juulsA/usb-c-pd-vps/hardware/ps-ch/step-models/WE-HCI_1890.stp

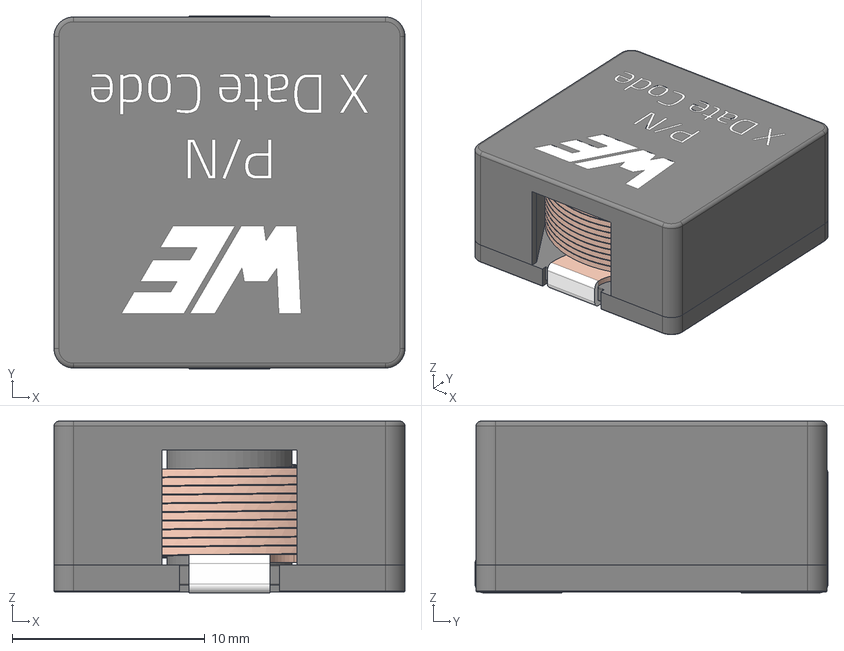
[picture p2: CAD file, 2025-10-03]
hardware/ps-ch/step-models/WE-HCI_1890.stp
18.2 x 18.3 x 8.90 mm
Gehäuse
Boden
Spule
