juulsA/usb-c-pd-vps/hardware/ps-ch/step-models/atx203sa.step

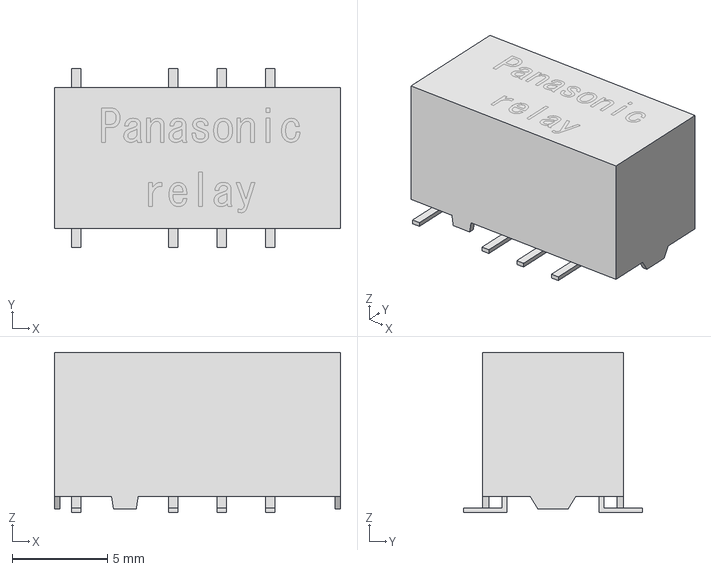
[picture p3: CAD file, 2025-10-03]
hardware/ps-ch/step-models/atx203sa.step
15.0 x 9.40 x 8.40 mm
