juulsA/usb-c-pd-vps/hardware/ps-ch/step-models/RPH0016B.stp

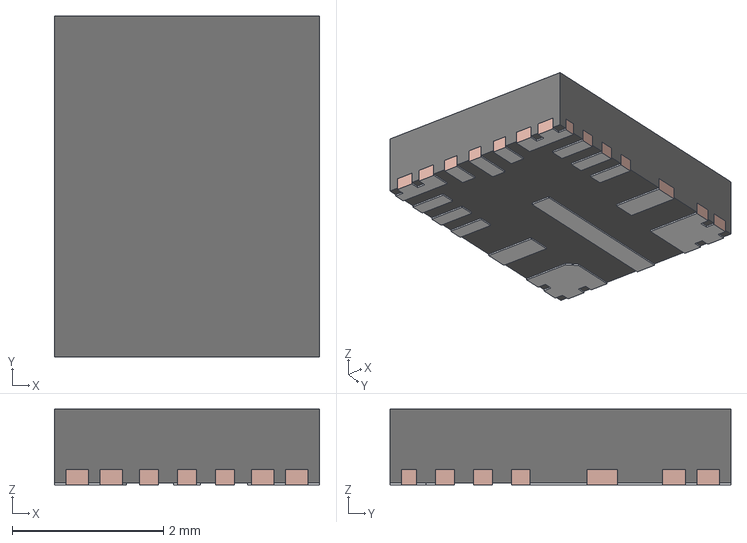
[picture p4: CAD file, 2025-10-03]
hardware/ps-ch/step-models/RPH0016B.stp
3.50 x 4.50 x 1.00 mm
FRAME
