juulsA/usb-c-pd-vps/hardware/ps-ch/step-models/WE-LQS_6045.stp

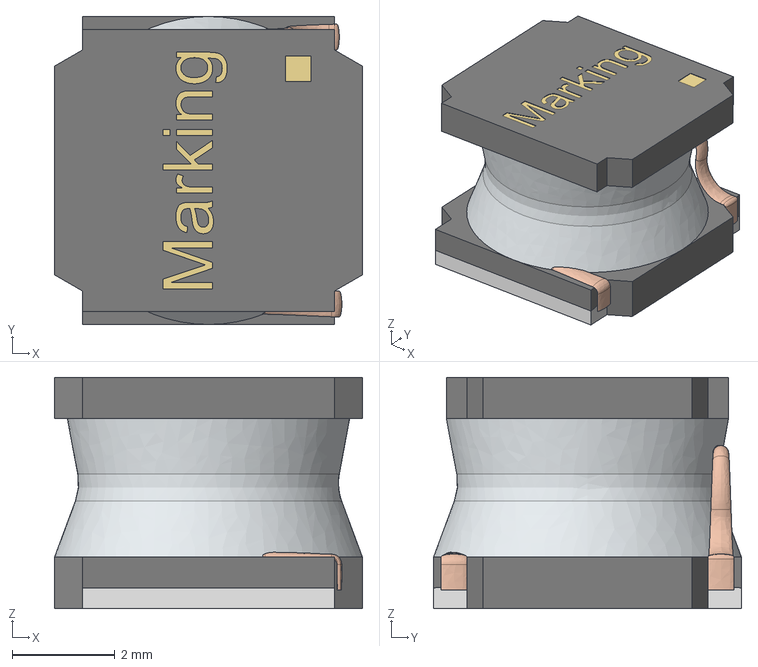
[picture p5: CAD file, 2025-10-03]
hardware/ps-ch/step-models/WE-LQS_6045.stp
6.00 x 6.00 x 4.50 mm
