juulsA/usb-c-pd-vps/hardware/ps-ch/step-models/WE-HCI_5040.stp

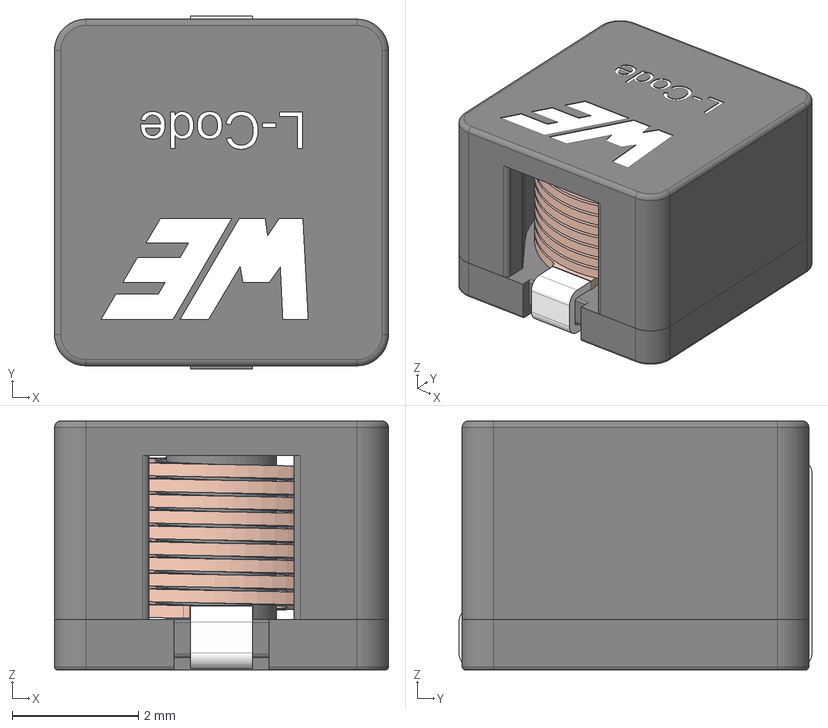
[picture p6: CAD file, 2025-10-03]
hardware/ps-ch/step-models/WE-HCI_5040.stp
5.30 x 5.60 x 3.95 mm
Gehäuse
Boden
Spule
