juulsA/usb-c-pd-vps/hardware/ps-ch/step-models/SOT669.step

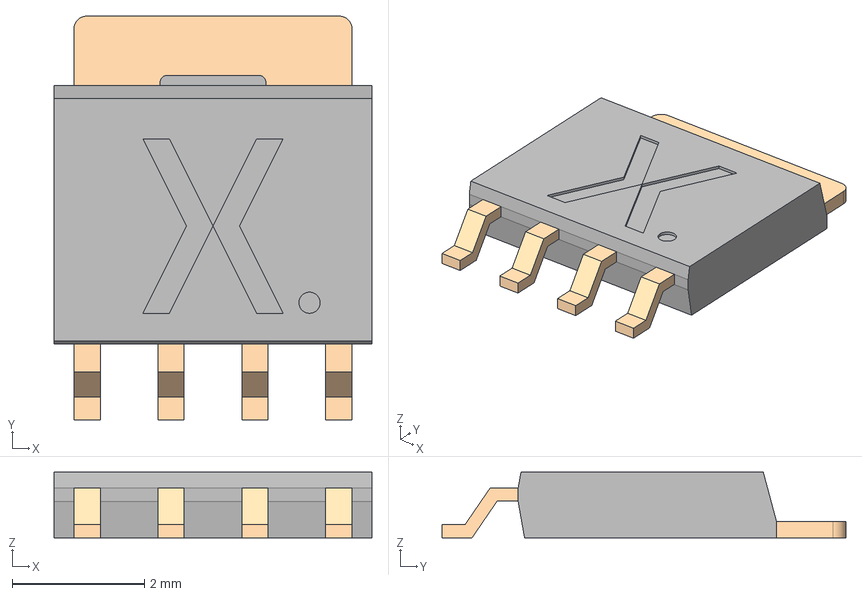
[picture p7: CAD file, 2025-10-03]
hardware/ps-ch/step-models/SOT669.step
4.81 x 6.11 x 0.998 mm
