juulsA/usb-c-pd-vps/hardware/ps-ch/step-models/EFD25.STEP

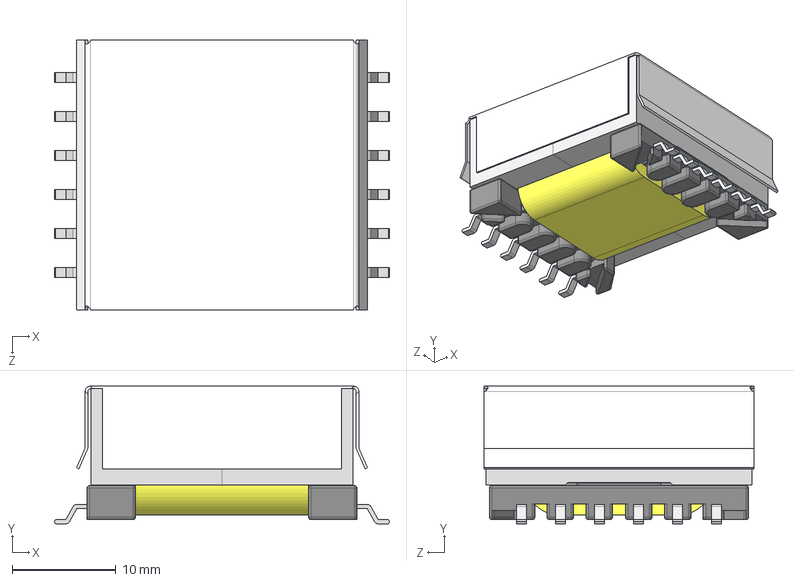
[picture p8: CAD file, 2025-10-03]
hardware/ps-ch/step-models/EFD25.STEP
32.3 x 13.3 x 26.0 mm
070-4476_6H
070-4476_coil
150-2104_6B x 2
139-0178_6B
