juulsA/usb-c-pd-vps/hardware/ps-ch/step-models/0009652028.stp

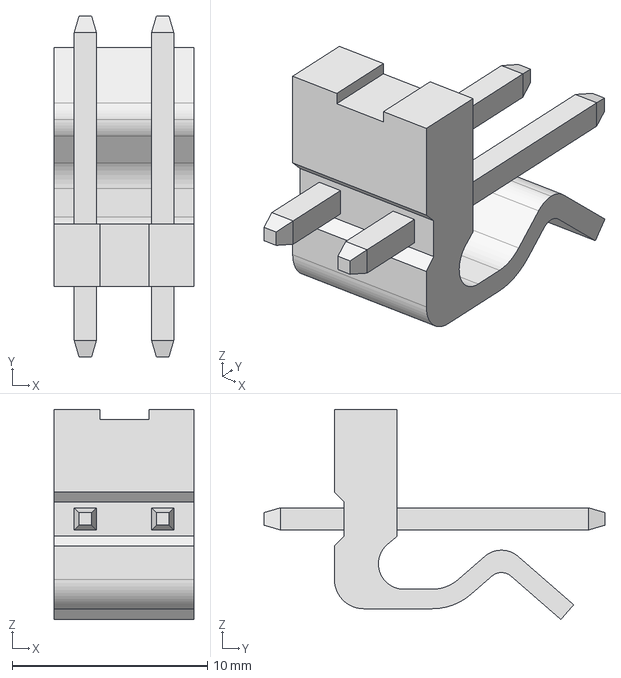
[picture p9: CAD file, 2025-10-05]
hardware/ps-ch/step-models/0009652028.stp
7.16 x 17.4 x 10.8 mm
