juulsA/usb-c-pd-vps/hardware/ps-ch/step-models/74279224101.stp

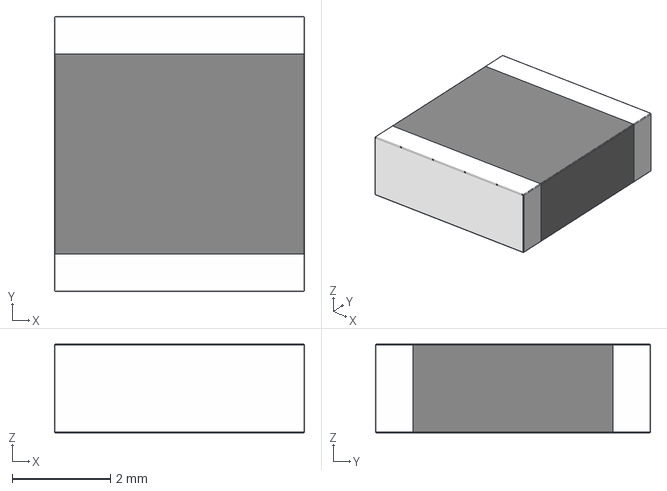
[picture p10: CAD file, 2025-10-03]
hardware/ps-ch/step-models/74279224101.stp
5.08 x 5.59 x 1.80 mm
