juulsA/usb-c-pd-vps/(commit log)

2025-06-28 Update usb-c-pd-vps.ipynb
    - added switching frequency calculation
2025-06-30 Create pwr_spl_concept.png
    - added power supply concept
2025-06-30 created kicad projects
    [ps-ch.kicad_pcb, ps-ch.kicad_sch, ps-mb.kicad_pcb, ps-mb.kicad_sch]
2025-07-01 started ps-ch schematics
    [ps-ch.kicad_sch]
2025-07-01 added lm61495
    [ps-ch.kicad_sch]
2025-07-03 added equations (unordered)
    [ps-ch.kicad_sch]
2025-07-05 changed voltage generation style
    updated all equations
2025-07-06 added AD5693RB
    [ps-ch.kicad_sch]
2025-07-06 added current limiting circuit
    [ps-ch.kicad_sch]
2025-07-07 added auto current limiter and auto voltage adjustment
    [ps-ch.kicad_sch]
2025-07-08 changed vsense circuit
    [ps-ch.kicad_sch]
2025-07-09 added AD5693R
    [ps-ch.kicad_sch]
2025-07-09 changed vout error correction
    [ps-ch.kicad_sch]
2025-07-10 simplified circuit
    -removed opamps
    [ps-ch.kicad_sch]
2025-07-13 added opa992
    [ps-ch.kicad_sch]
2025-07-18 added digital isolators
    [ps-ch.kicad_sch]
2025-07-20 -added 3V3 power supply and STM32
    [ps-ch.kicad_sch]
2025-07-20 defined gpios
    [ps-ch.kicad_sch]
2025-07-20 added series resistors for npn transistors
    [ps-ch.kicad_sch]
2025-07-27 Update ps-ch.kicad_sch
    -added 2nd digital isolator
    [ps-ch.kicad_sch]
2025-07-27 Update ps-ch.kicad_sch
    connected gpios
    [ps-ch.kicad_sch]
2025-07-27 updated porject description
    - updated readme
    - renamed gpios (stm32)
    [ps-ch.kicad_sch]
2025-07-27 Update ps-ch.kicad_sch
    - added testpoints to oscx_x
    [ps-ch.kicad_sch]
2025-07-27 edited schematics
    - selected npn/pnp
    - added connector for swd interface
    [ps-ch.kicad_sch]
2025-08-01 added components
    [ps-ch.kicad_sch]
2025-08-09 started making hierachical design
    [adc.kicad_sch, dac.kicad_sch, flyback_converter.kicad_sch, ps-ch.kicad_sch, stm32.kicad_sch, switch.kicad_sch]
2025-08-09 created voltage regulation
    [flyback_converter.kicad_sch, ps-ch.kicad_sch, voltage_regulation.kicad_sch]
2025-08-10 did some wiring
    [adc.kicad_sch, current_measurement.kicad_sch, dac.kicad_sch, flyback_converter.kicad_sch, ps-ch.kicad_sch, stm32.kicad_sch, switch.kicad_sch, voltage_correction.kicad_sch]
2025-08-10 more wiring
    - updated stm32 pinout
    - added load switch
    [switch.kicad_sch]
2025-08-16 drawn enabled circuit
    [ps-ch.kicad_sch, stm32.kicad_sch, switch.kicad_sch]
2025-08-16 Update switch.kicad_sch
    - connected nmos driver to vdc
    [switch.kicad_sch]
2025-08-24 added 74LVC126A
    [adc.kicad_sch, ps-ch.kicad_sch, switch.kicad_sch]
2025-09-14 - added component values/part numbers
    [current_measurement.kicad_sch, dac.kicad_sch, flyback_converter.kicad_sch, ps-ch.kicad_sch, stm32.kicad_sch, switch.kicad_sch]
2025-09-22 calculated voltage dividers
    [ps-ch.kicad_sch]
2025-09-23 added calculations and component values
    [ps-ch.kicad_sch, stm32.kicad_sch, voltage_correction.kicad_sch]
2025-09-23 calculated voltage correction
    [dac.kicad_sch, ps-ch.kicad_sch, stm32.kicad_sch, voltage_correction.kicad_sch]
2025-09-24 wired adc/added resolutions
    [adc.kicad_sch, current_measurement.kicad_sch, ps-ch.kicad_sch, voltage_correction.kicad_sch]
2025-09-24 parameterized flyback converter
    [current_measurement.kicad_sch, flyback_converter.kicad_sch, ps-ch.kicad_sch]
2025-09-25 changed voltage regulation (preregulator)
    [flyback_converter.kicad_sch, ps-ch.kicad_sch, switch.kicad_sch, voltage_correction.kicad_sch]
2025-09-25 improved circuit
    [adc.kicad_sch, flyback_converter.kicad_sch, switch.kicad_sch]
2025-09-25 added discharge resistors
    [ps-ch.kicad_sch]
2025-09-25 assigned footprints
    [adc.kicad_sch, current_measurement.kicad_sch, dac.kicad_sch, flyback_converter.kicad_sch, ps-ch.kicad_sch, stm32.kicad_sch]
2025-09-28 added snubber circuit components
    [flyback_converter.kicad_sch, ps-ch.kicad_sch, switch.kicad_sch]
2025-09-30 changed voltage sensing circuit
    [ps-ch.kicad_sch, stm32.kicad_sch, voltage_correction.kicad_sch]
2025-10-03 created and assigned footprints
    [74279224101 (rev1).stp, EFD25.STEP, RPH0016B.stp, SOT669.step, WE-HCI_1890.stp, WE-HCI_5040.stp, WE-LQS_6045.stp, atx203sa.step]
2025-10-03 first pcb sync
    [adc.kicad_sch, current_measurement.kicad_sch, dac.kicad_sch, flyback_converter.kicad_sch, ps-ch.kicad_pcb, ps-ch.kicad_sch, stm32.kicad_sch, switch.kicad_sch]
2025-10-05 removed cmc, replaced input/output connectors
    [0009652028.stp, adc.kicad_sch, current_measurement.kicad_sch, dac.kicad_sch, flyback_converter.kicad_sch, ps-ch.kicad_pcb, ps-ch.kicad_sch, stm32.kicad_sch]
2025-10-05 started floorplanning
    [74279224101.stp, ps-ch.kicad_pcb, ps-ch.kicad_sch, switch.kicad_sch, voltage_correction.kicad_sch]
